Krystepan/PCB_Nissan_v2/bom/Faurecia_Nissan_RPi_Motor_Controller_v2.png

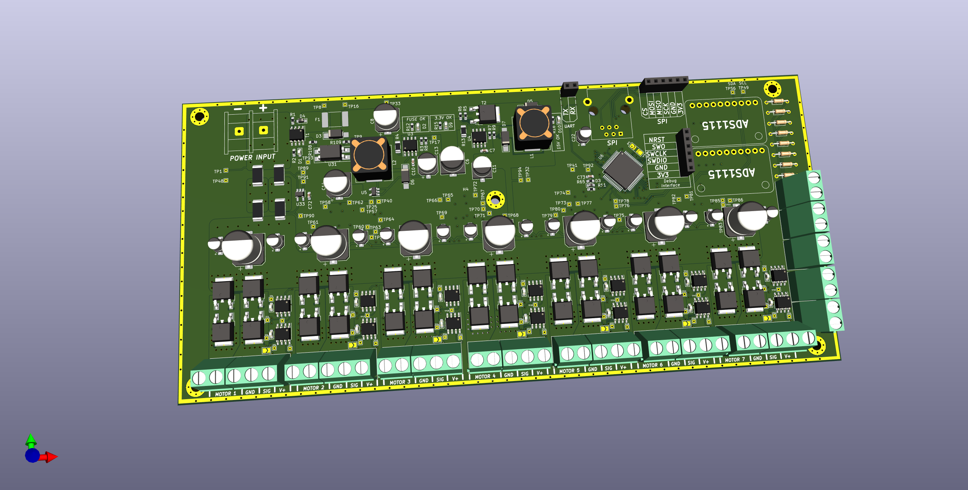
bom/Faurecia_Nissan_RPi_Motor_Controller_v2.png
