Krystepan/PCB_Nissan_v2/Faurecia_Nissan_RPi_Motor_Controller_v2_AR-Check.txt

AR checking written on:
'E:\Elektronika\10.KOMPLETNE PROJEKTY\FAURECIA_Nissan\PCB_Nissan_v2\Faurecia_Nissan_RPi_Motor_Controller_v2_AR-Check.txt'
'action_menu_annular_check.py'
version = 1.7.2
Testing PCB for Annular Rings
TH Pads >= 0.2 Vias >= 0.2
PHD margin on PTH = 0.3

AR Via violation of 0.0 at XY 189.789055,166.760257
AR Via violation of 0.05 at XY 170.883249,160.802444
AR Via violation of 0.0 at XY 141.666668,164.6375
AR Via violation of 0.0 at XY 248.716668,175.5475
AR Via violation of 0.05 at XY 198.798249,160.802444
AR Via violation of 0.0 at XY 300.466668,175.5175
AR Via violation of 0.0 at XY 151.566668,187.1375
AR Via violation of 0.0 at XY 258.816668,87.6375
AR Via violation of 0.0 at XY 103.816668,96.1375
AR Via violation of 0.0 at XY 180.066668,187.1375
AR Via violation of 0.0 at XY 134.966668,156.0175
AR Via violation of 0.0 at XY 133.826668,175.5275
AR Via violation of 0.0 at XY 301.316668,87.6375
AR Via violation of 0.0 at XY 149.566668,108.8875
AR Via violation of 0.0 at XY 158.566668,108.8875
AR Via violation of 0.0 at XY 273.986668,156.0675
AR Via violation of 0.0 at XY 170.566668,187.1375
AR Via violation of 0.0 at XY 265.816668,187.1375
AR Via violation of 0.0 at XY 137.316668,187.1375
AR Via violation of 0.0 at XY 153.066668,100.8875
AR Via violation of 0.0 at XY 103.816668,124.6375
AR Via violation of 0.0 at XY 103.816668,143.6375
AR Via violation of 0.0 at XY 189.486668,175.5475
AR Via violation of 0.05 at XY 254.333249,160.857444
AR Via violation of 0.0 at XY 157.816668,87.6375
AR Via violation of 0.0 at XY 129.316668,87.6375
AR Via violation of 0.0 at XY 175.316668,187.1375
AR Via violation of 0.0 at XY 181.566668,87.6375
AR Via violation of 0.0 at XY 220.816668,87.6375
AR Via violation of 0.0 at XY 186.566668,110.6375
AR Via violation of 0.0 at XY 179.276668,164.0975
AR Via violation of 0.0 at XY 276.386668,175.5975
AR Via violation of 0.0 at XY 227.316668,94.3875
AR Via violation of 0.0 at XY 194.566668,187.1375
AR Via violation of 0.05 at XY 115.283249,160.794944
AR Via violation of 0.0 at XY 301.546668,165.4075
AR Via violation of 0.0 at XY 232.566668,187.1375
AR Via violation of 0.0 at XY 115.066668,87.6375
AR Via violation of 0.0 at XY 103.816668,172.1375
AR Via violation of 0.0 at XY 207.006668,164.0975
AR Via violation of 0.0 at XY 261.066668,187.1375
AR Via violation of 0.0 at XY 217.316668,175.5275
AR Via violation of 0.0 at XY 125.066668,133.6375
AR Via violation of 0.0 at XY 190.536668,155.9975
AR Via violation of 0.05 at XY 125.057267,160.7601
AR Via violation of 0.0 at XY 217.712687,166.736184
AR Via violation of 0.0 at XY 245.136668,175.5675
AR Via violation of 0.0 at XY 103.816668,153.1375
AR Via violation of 0.0 at XY 137.406668,175.5275
AR Via violation of 0.0 at XY 142.948395,119.897524
AR Via violation of 0.0 at XY 251.566668,187.1375
AR Via violation of 0.0 at XY 304.316668,187.1375
AR Via violation of 0.0 at XY 320.255573,163.640706
AR Via violation of 0.0 at XY 134.066668,87.6375
AR Via violation of 0.0 at XY 206.566668,87.6375
AR Via violation of 0.0 at XY 165.246668,175.5975
AR Via violation of 0.0 at XY 254.066668,87.6375
AR Via violation of 0.0 at XY 217.926668,154.0875
AR Via violation of 0.0 at XY 263.566668,87.6375
AR Via violation of 0.0 at XY 103.816668,167.3875
AR Via violation of 0.0 at XY 300.856668,166.7775
AR Via violation of 0.0 at XY 320.255573,168.390706
AR Via violation of 0.0 at XY 197.346668,164.6375
AR Via violation of 0.0 at XY 161.686668,175.6075
AR Via violation of 0.0 at XY 309.066668,187.1375
AR Via violation of 0.0 at XY 242.066668,187.1375
AR Via violation of 0.0 at XY 320.255573,97.140706
AR Via violation of 0.0 at XY 145.989759,120.889683
AR Via violation of 0.0 at XY 320.255573,144.640706
AR Via violation of 0.0 at XY 216.066668,87.6375
AR Via violation of 0.0 at XY 103.816668,134.1375
AR Via violation of 0.0 at XY 113.566668,187.1375
AR Via violation of 0.0 at XY 320.255573,149.390706
AR Via violation of 0.0 at XY 320.255573,154.140706
AR Via violation of 0.0 at XY 103.816668,129.3875
AR Via violation of 0.0 at XY 146.816668,187.1375
AR Via violation of 0.0 at XY 313.816668,187.1375
AR Via violation of 0.0 at XY 161.066668,187.1375
AR Via violation of 0.0 at XY 239.816668,87.6375
AR Via violation of 0.05 at XY 264.107267,160.8226
AR Via violation of 0.0 at XY 235.066668,87.6375
AR Via violation of 0.0 at XY 191.066668,87.6375
AR Via violation of 0.0 at XY 151.556668,164.1775
AR Via violation of 0.0 at XY 277.816668,87.6375
AR Via violation of 0.0 at XY 184.816668,187.1375
AR Via violation of 0.0 at XY 118.316668,187.1375
AR Via violation of 0.0 at XY 190.506668,165.3875
AR Via violation of 0.0 at XY 291.816668,87.6375
AR Via violation of 0.0 at XY 304.016668,175.4975
AR Via violation of 0.0 at XY 218.436668,155.3275
AR Via violation of 0.05 at XY 143.086668,160.8775
AR Via violation of 0.0 at XY 140.799999,93.846719
AR Via violation of 0.0 at XY 103.816668,138.8875
AR Via violation of 0.0 at XY 119.816668,87.6375
AR Via violation of 0.0 at XY 138.816668,87.6375
AR Via violation of 0.0 at XY 135.066668,135.3875
AR Via violation of 0.0 at XY 103.816668,157.8875
AR Via violation of 0.0 at XY 162.786668,156.0575
AR Via violation of 0.0 at XY 143.066668,105.6375
AR Via violation of 0.0 at XY 125.066668,136.1375
AR Via violation of 0.0 at XY 233.080979,100.046421
AR Via violation of 0.0 at XY 165.816668,187.1375
AR Via violation of 0.0 at XY 103.816668,100.8875
AR Via violation of 0.0 at XY 227.816668,187.1375
AR Via violation of 0.0 at XY 143.566668,87.6375
AR Via violation of 0.0 at XY 123.606668,164.1375
AR Via violation of 0.0 at XY 211.316668,87.6375
AR Via violation of 0.0 at XY 208.558823,104.523369
AR Via violation of 0.0 at XY 218.316668,187.1375
AR Via violation of 0.0 at XY 156.316668,187.1375
AR Via violation of 0.05 at XY 152.907267,160.8226
AR Via violation of 0.0 at XY 225.566668,87.6375
AR Via violation of 0.0 at XY 234.906668,164.1575
AR Via violation of 0.0 at XY 103.816668,115.1375
AR Via violation of 0.0 at XY 320.255573,177.890706
AR Via violation of 0.0 at XY 126.316668,133.6375
AR Via violation of 0.0 at XY 294.816668,187.1375
AR Via violation of 0.0 at XY 176.816668,87.6375
AR Via violation of 0.0 at XY 153.066668,87.6375
AR Via violation of 0.0 at XY 237.316668,187.1375
AR Via violation of 0.0 at XY 134.136668,166.7775
AR Via violation of 0.0 at XY 218.406668,165.2875
AR Via violation of 0.0 at XY 142.066668,187.1375
AR Via violation of 0.0 at XY 273.956668,165.5275
AR Via violation of 0.0 at XY 320.255573,106.640706
AR Via violation of 0.0 at XY 183.816668,99.8875
AR Via violation of 0.0 at XY 113.856668,164.6075
AR Via violation of 0.0 at XY 223.066668,187.1375
AR Via violation of 0.05 at XY 281.946668,160.78
AR Via violation of 0.0 at XY 262.646668,164.1975
AR Via violation of 0.0 at XY 273.246668,166.8275
AR Via violation of 0.05 at XY 247.466668,115.314
AR Via violation of 0.0 at XY 132.566668,187.1375
AR Via violation of 0.05 at XY 180.657267,160.7676
AR Via violation of 0.0 at XY 220.916668,175.5375
AR Via violation of 0.0 at XY 103.816668,148.3875
AR Via violation of 0.0 at XY 124.566668,87.6375
AR Via violation of 0.0 at XY 320.255573,125.640706
AR Via violation of 0.0 at XY 103.816668,162.6375
AR Via violation of 0.0 at XY 320.255573,116.140706
AR Via violation of 0.05 at XY 226.583249,160.802444
AR Via violation of 0.0 at XY 296.566668,87.6375
AR Via violation of 0.0 at XY 280.566668,187.1375
AR Via violation of 0.0 at XY 320.255573,135.140706
AR Via violation of 0.0 at XY 246.816668,187.1375
AR Via violation of 0.0 at XY 103.816668,105.6375
AR Via violation of 0.0 at XY 201.816668,87.6375
AR Via violation of 0.0 at XY 246.226668,156.0275
AR Via violation of 0.0 at XY 244.566668,87.6375
AR Via violation of 0.0 at XY 252.766668,164.2675
AR Via violation of 0.0 at XY 116.316668,135.3875
AR Via violation of 0.0 at XY 103.816668,119.8875
AR Via violation of 0.0 at XY 320.255573,158.890706
AR Via violation of 0.0 at XY 192.996668,175.5175
AR Via violation of 0.0 at XY 268.316668,87.6375
AR Via violation of 0.0 at XY 103.816668,110.3875
AR Via violation of 0.0 at XY 205.066668,118.6375
AR Via violation of 0.0 at XY 162.016668,166.8175
AR Via violation of 0.0 at XY 126.316668,136.1375
AR Via violation of 0.0 at XY 320.255573,130.390706
AR Via violation of 0.0 at XY 285.316668,187.1375
AR Via violation of 0.0 at XY 208.816668,187.1375
AR Via violation of 0.0 at XY 167.316668,87.6375
AR Via violation of 0.0 at XY 270.566668,187.1375
AR Via violation of 0.0 at XY 230.316668,87.6375
AR Via violation of 0.0 at XY 282.566668,87.6375
AR Via violation of 0.0 at XY 261.066668,121.9125
AR Via violation of 0.0 at XY 156.066668,115.6375
AR Via violation of 0.0 at XY 320.255573,101.890706
AR Via violation of 0.0 at XY 193.566668,100.1375
AR Via violation of 0.0 at XY 103.816668,176.8875
AR Via violation of 0.0 at XY 189.566668,187.1375
AR Via violation of 0.0 at XY 108.816668,187.1375
AR Via violation of 0.0 at XY 272.826668,175.6175
AR Via violation of 0.0 at XY 134.906668,165.4375
AR Via violation of 0.0 at XY 127.816668,187.1375
AR Via violation of 0.0 at XY 306.066668,87.6375
AR Via violation of 0.0 at XY 160.683314,127.710046
AR Via violation of 0.0 at XY 320.255573,173.140706
AR Via violation of 0.0 at XY 148.316668,87.6375
AR Via violation of 0.0 at XY 195.816668,87.6375
AR Via violation of 0.05 at XY 291.720686,160.745156
AR Via violation of 0.0 at XY 245.524086,166.738215
AR Via violation of 0.0 at XY 301.576668,155.9475
AR Via violation of 0.0 at XY 225.016668,164.2475
AR Via violation of 0.0 at XY 287.066668,87.6375
AR Via violation of 0.0 at XY 320.255573,139.890706
AR Via violation of 0.0 at XY 169.276668,164.5175
AR Via violation of 0.0 at XY 273.066668,87.6375
AR Via violation of 0.0 at XY 199.316668,187.1375
AR Via violation of 0.0 at XY 320.255573,111.390706
AR Via violation of 0.0 at XY 246.186668,165.3775
AR Via violation of 0.0 at XY 275.316668,187.1375
AR Via violation of 0.05 at XY 208.572267,160.7676
AR Via violation of 0.0 at XY 162.566668,87.6375
AR Via violation of 0.0 at XY 172.066668,87.6375
AR Via violation of 0.0 at XY 123.066668,187.1375
AR Via violation of 0.0 at XY 204.066668,187.1375
AR Via violation of 0.0 at XY 249.316668,87.6375
AR Via violation of 0.0 at XY 290.176668,164.0575
AR Via violation of 0.0 at XY 256.316668,187.1375
AR Via violation of 0.0 at XY 213.566668,187.1375
AR Via violation of 0.0 at XY 299.566668,187.1375
AR Via violation of 0.05 at XY 236.357267,160.7676
AR Via violation of 0.0 at XY 186.316668,87.6375
AR Via violation of 0.0 at XY 320.255573,120.890706
AR Via violation of 0.0 at XY 153.638862,123.097665
AR Via violation of 0.0 at XY 290.066668,187.1375
AR Via violation of 0.0 at XY 162.736668,165.5675
AR Via violation of 0.0 at XY 299.866668,139.6875
AR Via violation of 0.05 at XY 249.833249,140.102444
AR Via violation of 0.05 at XY 277.183249,167.157444
AR Via violation of 0.05 at XY 305.395059,155.862804
AR Via violation of 0.05 at XY 166.58164,155.940248
AR Via violation of 0.05 at XY 194.33164,155.885248
AR Via violation of 0.05 at XY 222.048249,140.102444
AR Via violation of 0.05 at XY 191.133249,159.502444
AR Via violation of 0.05 at XY 250.03164,155.885248
AR Via violation of 0.0 at XY 144.296724,138.9625
AR Via violation of 0.05 at XY 135.533249,159.494944
AR Via violation of 0.05 at XY 138.133249,167.094944
AR Via violation of 0.05 at XY 249.433249,167.102444
AR Via violation of 0.05 at XY 222.24664,155.885248
AR Via violation of 0.05 at XY 193.733249,167.102444
AR Via violation of 0.0 at XY 135.133249,138.944944
AR Via violation of 0.05 at XY 165.983249,167.157444
AR Via violation of 0.05 at XY 163.383249,159.557444
AR Via violation of 0.05 at XY 302.196668,159.48
AR Via violation of 0.05 at XY 138.73164,155.877748
AR Via violation of 0.05 at XY 221.648249,167.102444
AR Via violation of 0.05 at XY 274.583249,159.557444
AR Via violation of 0.05 at XY 194.133249,140.102444
AR Via violation of 0.05 at XY 219.048249,159.502444
AR Via violation of 0.05 at XY 277.583249,140.157444
AR Via violation of 0.05 at XY 304.796668,167.08
AR Via violation of 0.05 at XY 166.383249,140.157444
AR Via violation of 0.05 at XY 246.833249,159.502444
AR Via violation of 0.0 at XY 116.35531,138.97555
AR Via violation of 0.05 at XY 277.78164,155.940248
AR Via violation of 0.0 at XY 198.559215,124.723719
AR Via violation of 0.0 at XY 195.479612,135.137785
AR Via violation of 0.0 at XY 136.176668,165.4175
AR Via violation of 0.0 at XY 145.989759,122.603745
AR Via violation of 0.0 at XY 258.066668,110.1875
AR Via violation of 0.0 at XY 265.291668,131.0125
AR Via violation of 0.0 at XY 157.146668,174.6675
AR Via violation of 0.0 at XY 151.308841,134.967301
AR Via violation of 0.0 at XY 191.776668,165.3575
AR Via violation of 0.0 at XY 262.166668,121.9875
AR Via violation of 0.0 at XY 240.596668,174.5875
AR Via violation of 0.0 at XY 302.816668,165.3575
AR Via violation of 0.0 at XY 254.566668,110.9625
AR Via violation of 0.0 at XY 275.256668,156.0675
AR Via violation of 0.0 at XY 234.816668,131.6375
AR Via violation of 0.0 at XY 136.186668,156.0275
AR Via violation of 0.0 at XY 278.291562,135.277625
AR Via violation of 0.0 at XY 277.68239,132.092477
AR Via violation of 0.0 at XY 247.496668,156.0175
AR Via violation of 0.0 at XY 254.766668,114.1125
AR Via violation of 0.0 at XY 249.341668,119.7625
AR Via violation of 0.05 at XY 280.666668,125.1875
AR Via violation of 0.0 at XY 240.991668,108.3125
AR Via violation of 0.0 at XY 129.296668,174.5875
AR Via violation of 0.0 at XY 260.466668,128.9125
AR Via violation of 0.05 at XY 265.541668,124.0375
AR Via violation of 0.0 at XY 219.716668,155.3675
AR Via violation of 0.0 at XY 219.696668,165.2975
AR Via violation of 0.0 at XY 302.856668,155.9575
AR Via violation of 0.0 at XY 143.938392,122.603745
AR Via violation of 0.0 at XY 164.036668,165.5675
AR Via violation of 0.0 at XY 159.989094,103.400824
AR Via violation of 0.0 at XY 239.641668,125.5375
AR Via violation of 0.0 at XY 249.741668,117.6875
AR Via violation of 0.0 at XY 245.741668,119.7875
AR Via violation of 0.0 at XY 156.324494,125.078891
AR Via violation of 0.0 at XY 164.056668,156.0475
AR Via violation of 0.0 at XY 295.936668,174.5975
AR Via violation of 0.0 at XY 241.091668,106.9875
AR Via violation of 0.05 at XY 265.333125,125.391918
AR Via violation of 0.0 at XY 191.566668,100.1375
AR Via violation of 0.0 at XY 212.796668,174.5875
AR Via violation of 0.05 at XY 234.576551,91.849677
AR Via violation of 0.0 at XY 253.591668,123.9625
AR Via violation of 0.0 at XY 156.041668,120.7375
AR Via violation of 0.0 at XY 195.185798,132.319349
AR Via violation of 0.0 at XY 268.306668,174.6575
AR Via violation of 0.0 at XY 275.196668,165.5375
AR Via violation of 0.0 at XY 191.816668,156.0475
AR Via violation of 0.05 at XY 239.751217,91.816435
AR Via violation of 0.0 at XY 247.466668,165.3675
AR Via violation of 0.0 at XY 184.856668,174.5875
AR Via violation of 0.0 at XY 250.066668,110.5625
AR Via violation of 0.0 at XY 248.316668,112.1625
AR Via violation of 0.0 at XY 259.116668,125.1375
AR Via violation of 0.0 at XY 260.291668,126.0875
AR Via violation of 0.05 at XY 169.791668,129.1875
AR Via violation of 0.0 at XY 261.441668,125.8625
AR Via violation of 0.0 at XY 262.066668,124.7875
AR Via violation of 0.0 at XY 201.666668,136.2375
AR Via violation of 0.0 at XY 251.066668,116.3875
AR Via violation of 0.0 at XY 259.291668,113.8625
AR Via violation of 0.0 at XY 153.066668,127.6875
AR Via violation of 0.0 at XY 246.366668,123.9875
AR Via violation of 0.0 at XY 156.916668,127.6875
AR Via violation of 0.0 at XY 244.941668,124.6125
AR Via violation of 0.0 at XY 159.416668,132.6375
AR Via violation of 0.05 at XY 167.716668,129.4125
AR Via violation of 0.0 at XY 155.616668,132.6375
AR Via violation of 0.0 at XY 195.166668,127.3875
AR Via violation of 0.05 at XY 245.541668,128.3125
AR Via violation of 0.0 at XY 198.966668,127.3375
AR Via violation of 0.0 at XY 197.716668,132.3875
AR Via violation of 0.0 at XY 201.516668,132.3375
AR Via violation of 0.0 at XY 248.666668,128.861
AR Via violation of 0.0 at XY 245.566668,115.2625
AR Via violation of 0.0 at XY 262.195477,123.896403
AR Via violation of 0.0 at XY 262.142136,123.071624
AR Via violation of 0.0 at XY 242.866668,136.2375
AR Via violation of 0.0 at XY 261.266668,115.5125
AR Via violation of 0.05 at XY 132.966668,157.6875
AR Via violation of 0.0 at XY 258.816668,112.7625
AR Via violation of 0.0 at XY 240.266668,127.1375
AR Via violation of 0.0 at XY 236.456668,127.1625
AR Via violation of 0.0 at XY 242.806668,132.1125
AR Via violation of 0.0 at XY 238.966668,132.0875
AR Via violation of 0.05 at XY 256.066668,122.0625
AR Via violation of 0.05 at XY 131.883249,167.344944
AR Via violation of 0.05 at XY 277.631668,127.1375
AR Via violation of 0.05 at XY 281.466668,127.1875
AR Via violation of 0.0 at XY 254.341668,115.5375
AR Via violation of 0.0 at XY 280.216668,132.1875
AR Via violation of 0.0 at XY 284.004168,132.115
AR Via violation of 0.05 at XY 160.816668,157.75
AR Via violation of 0.05 at XY 159.733249,167.407444
AR Via violation of 0.05 at XY 188.566668,157.695
AR Via violation of 0.05 at XY 187.483249,167.352444
AR Via violation of 0.05 at XY 216.481668,157.695
AR Via violation of 0.05 at XY 215.398249,167.352444
AR Via violation of 0.05 at XY 244.266668,157.695
AR Via violation of 0.05 at XY 243.183249,167.352444
AR Via violation of 0.05 at XY 272.016668,157.75
AR Via violation of 0.05 at XY 270.933249,167.407444
AR Via violation of 0.0 at XY 139.666668,153.1375
AR Via violation of 0.05 at XY 134.873249,157.634944
AR Via violation of 0.0 at XY 149.316668,138.8375
AR Via violation of 0.0 at XY 150.716668,138.8375
AR Via violation of 0.05 at XY 134.033249,168.169944
AR Via violation of 0.0 at XY 167.816668,138.9375
AR Via violation of 0.0 at XY 167.466668,153.6375
AR Via violation of 0.05 at XY 162.723249,157.697444
AR Via violation of 0.0 at XY 169.716668,138.9875
AR Via violation of 0.05 at XY 161.883249,168.232444
AR Via violation of 0.0 at XY 204.266668,133.2375
AR Via violation of 0.05 at XY 218.388249,157.642444
AR Via violation of 0.0 at XY 220.466668,140.0875
AR Via violation of 0.05 at XY 217.548249,168.177444
AR Via violation of 0.0 at XY 223.766668,140.0875
AR Via violation of 0.0 at XY 198.985359,131.611141
AR Via violation of 0.05 at XY 190.473249,157.642444
AR Via violation of 0.0 at XY 192.566668,140.1375
AR Via violation of 0.0 at XY 195.766668,140.1375
AR Via violation of 0.05 at XY 189.633249,168.177444
AR Via violation of 0.0 at XY 247.066668,133.3375
AR Via violation of 0.05 at XY 273.923249,157.697444
AR Via violation of 0.0 at XY 240.266668,133.8875
AR Via violation of 0.05 at XY 273.083249,168.232444
AR Via violation of 0.0 at XY 248.316668,140.1875
AR Via violation of 0.05 at XY 246.173249,157.642444
AR Via violation of 0.05 at XY 245.333249,168.177444
AR Via violation of 0.0 at XY 251.716668,140.0875
AR Via violation of 0.05 at XY 299.630087,157.672556
AR Via violation of 0.05 at XY 298.546668,167.33
AR Via violation of 0.0 at XY 253.141668,126.3875
AR Via violation of 0.0 at XY 251.516668,120.1375
AR Via violation of 0.0 at XY 253.441668,99.8125
AR Via violation of 0.05 at XY 252.040168,121.414
AR Via violation of 0.0 at XY 254.541668,98.9875
AR Via violation of 0.0 at XY 254.141668,126.6875
AR Via violation of 0.05 at XY 301.536668,157.62
AR Via violation of 0.05 at XY 300.696668,168.155
AR Via violation of 0.0 at XY 239.739168,93.9875
AR Via violation of 0.0 at XY 234.714168,93.9875
AR Via violation of 0.0 at XY 121.466668,166.4375
AR Via violation of 0.0 at XY 116.733334,171.4375
AR Via violation of 0.0 at XY 120.066668,171.4375
AR Via violation of 0.0 at XY 121.466668,168.0375
AR Via violation of 0.0 at XY 115.066668,171.4375
AR Via violation of 0.05 at XY 119.965749,164.744944
AR Via violation of 0.05 at XY 119.870749,157.369944
AR Via violation of 0.0 at XY 113.666668,169.8375
AR Via violation of 0.05 at XY 132.906668,163.8575
AR Via violation of 0.0 at XY 113.666668,168.2375
AR Via violation of 0.0 at XY 118.4,171.4375
AR Via violation of 0.0 at XY 113.666668,166.6375
AR Via violation of 0.0 at XY 121.466668,169.6375
AR Via violation of 0.0 at XY 123.466668,166.4375
AR Via violation of 0.0 at XY 123.466668,168.0375
AR Via violation of 0.0 at XY 125.866668,171.4375
AR Via violation of 0.05 at XY 136.633249,168.494944
AR Via violation of 0.0 at XY 124.266668,171.4375
AR Via violation of 0.0 at XY 127.466668,171.4375
AR Via violation of 0.0 at XY 123.466668,169.6375
AR Via violation of 0.0 at XY 129.066668,171.4375
AR Via violation of 0.0 at XY 146.25,171.5
AR Via violation of 0.0 at XY 149.316668,168.1
AR Via violation of 0.05 at XY 147.720749,157.432444
AR Via violation of 0.0 at XY 141.516668,169.9
AR Via violation of 0.0 at XY 149.316668,166.5
AR Via violation of 0.05 at XY 147.815749,164.807444
AR Via violation of 0.0 at XY 142.916668,171.5
AR Via violation of 0.0 at XY 149.316668,169.7
AR Via violation of 0.0 at XY 141.516668,168.3
AR Via violation of 0.05 at XY 160.706668,163.9775
AR Via violation of 0.0 at XY 144.583334,171.5
AR Via violation of 0.0 at XY 147.916668,171.5
AR Via violation of 0.0 at XY 141.516668,166.7
AR Via violation of 0.0 at XY 153.716668,171.5
AR Via violation of 0.0 at XY 151.316668,166.5
AR Via violation of 0.0 at XY 155.316668,171.5
AR Via violation of 0.0 at XY 156.916668,171.5
AR Via violation of 0.0 at XY 151.316668,169.7
AR Via violation of 0.0 at XY 152.116668,171.5
AR Via violation of 0.05 at XY 164.483249,168.557444
AR Via violation of 0.0 at XY 151.316668,168.1
AR Via violation of 0.05 at XY 175.565749,164.752444
AR Via violation of 0.0 at XY 169.266668,168.245
AR Via violation of 0.0 at XY 172.333334,171.445
AR Via violation of 0.0 at XY 177.066668,166.445
AR Via violation of 0.0 at XY 177.066668,169.645
AR Via violation of 0.0 at XY 169.266668,166.645
AR Via violation of 0.05 at XY 188.276668,163.9375
AR Via violation of 0.0 at XY 174.0,171.445
AR Via violation of 0.0 at XY 175.666668,171.445
AR Via violation of 0.0 at XY 169.266668,169.845
AR Via violation of 0.0 at XY 170.666668,171.445
AR Via violation of 0.05 at XY 175.470749,157.377444
AR Via violation of 0.0 at XY 177.066668,168.045
AR Via violation of 0.05 at XY 192.233249,168.502444
AR Via violation of 0.0 at XY 184.666668,171.445
AR Via violation of 0.0 at XY 179.066668,168.045
AR Via violation of 0.0 at XY 179.066668,166.445
AR Via violation of 0.0 at XY 183.066668,171.445
AR Via violation of 0.0 at XY 181.466668,171.445
AR Via violation of 0.0 at XY 179.066668,169.645
AR Via violation of 0.0 at XY 179.866668,171.445
AR Via violation of 0.0 at XY 198.581668,171.445
AR Via violation of 0.0 at XY 204.981668,166.445
AR Via violation of 0.0 at XY 204.981668,169.645
AR Via violation of 0.0 at XY 197.181668,166.645
AR Via violation of 0.0 at XY 201.915,171.445
AR Via violation of 0.0 at XY 200.248334,171.445
AR Via violation of 0.05 at XY 216.346668,163.8675
AR Via violation of 0.05 at XY 203.480749,164.752444
AR Via violation of 0.05 at XY 203.385749,157.377444
AR Via violation of 0.0 at XY 197.181668,169.845
AR Via violation of 0.0 at XY 204.981668,168.045
AR Via violation of 0.0 at XY 197.181668,168.245
AR Via violation of 0.0 at XY 203.581668,171.445
AR Via violation of 0.0 at XY 210.981668,171.445
AR Via violation of 0.0 at XY 209.381668,171.445
AR Via violation of 0.05 at XY 220.148249,168.502444
AR Via violation of 0.0 at XY 212.581668,171.445
AR Via violation of 0.0 at XY 206.981668,169.645
AR Via violation of 0.0 at XY 206.981668,168.045
AR Via violation of 0.0 at XY 207.781668,171.445
AR Via violation of 0.0 at XY 206.981668,166.445
AR Via violation of 0.0 at XY 231.366668,171.445
AR Via violation of 0.0 at XY 232.766668,168.045
AR Via violation of 0.0 at XY 224.966668,166.645
AR Via violation of 0.0 at XY 228.033334,171.445
AR Via violation of 0.05 at XY 244.166668,163.8675
AR Via violation of 0.05 at XY 231.265749,164.752444
AR Via violation of 0.0 at XY 232.766668,169.645
AR Via violation of 0.05 at XY 231.170749,157.377444
AR Via violation of 0.0 at XY 224.966668,168.245
AR Via violation of 0.0 at XY 232.766668,166.445
AR Via violation of 0.0 at XY 229.7,171.445
AR Via violation of 0.0 at XY 224.966668,169.845
AR Via violation of 0.0 at XY 226.366668,171.445
AR Via violation of 0.0 at XY 237.166668,171.445
AR Via violation of 0.0 at XY 234.766668,169.645
AR Via violation of 0.0 at XY 235.566668,171.445
AR Via violation of 0.0 at XY 234.766668,166.445
AR Via violation of 0.0 at XY 234.766668,168.045
AR Via violation of 0.05 at XY 247.933249,168.502444
AR Via violation of 0.0 at XY 238.766668,171.445
AR Via violation of 0.0 at XY 240.366668,171.445
AR Via violation of 0.05 at XY 259.015749,164.807444
AR Via violation of 0.0 at XY 260.516668,168.1
AR Via violation of 0.0 at XY 257.45,171.5
AR Via violation of 0.0 at XY 254.116668,171.5
AR Via violation of 0.05 at XY 271.966668,163.9875
AR Via violation of 0.0 at XY 260.516668,166.5
AR Via violation of 0.05 at XY 258.920749,157.432444
AR Via violation of 0.0 at XY 255.783334,171.5
AR Via violation of 0.0 at XY 252.716668,166.7
AR Via violation of 0.0 at XY 260.516668,169.7
AR Via violation of 0.0 at XY 259.116668,171.5
AR Via violation of 0.0 at XY 252.716668,169.9
AR Via violation of 0.0 at XY 252.716668,168.3
AR Via violation of 0.0 at XY 262.516668,169.7
AR Via violation of 0.0 at XY 262.516668,166.5
AR Via violation of 0.0 at XY 268.116668,171.5
AR Via violation of 0.0 at XY 266.516668,171.5
AR Via violation of 0.0 at XY 262.516668,168.1
AR Via violation of 0.05 at XY 275.683249,168.557444
AR Via violation of 0.0 at XY 263.316668,171.5
AR Via violation of 0.0 at XY 264.916668,171.5
AR Via violation of 0.0 at XY 288.130087,166.422556
AR Via violation of 0.0 at XY 281.730087,171.422556
AR Via violation of 0.05 at XY 286.534168,157.355
AR Via violation of 0.0 at XY 286.730087,171.422556
AR Via violation of 0.0 at XY 288.130087,169.622556
AR Via violation of 0.0 at XY 280.330087,168.222556
AR Via violation of 0.0 at XY 283.396753,171.422556
AR Via violation of 0.0 at XY 288.130087,168.022556
AR Via violation of 0.0 at XY 285.063419,171.422556
AR Via violation of 0.05 at XY 286.629168,164.73
AR Via violation of 0.0 at XY 280.330087,169.822556
AR Via violation of 0.05 at XY 299.566668,163.8575
AR Via violation of 0.0 at XY 280.330087,166.622556
AR Via violation of 0.0 at XY 290.130087,166.422556
AR Via violation of 0.0 at XY 290.130087,169.622556
AR Via violation of 0.0 at XY 290.130087,168.022556
AR Via violation of 0.0 at XY 292.530087,171.422556
AR Via violation of 0.05 at XY 303.296668,168.48
AR Via violation of 0.0 at XY 295.730087,171.422556
AR Via violation of 0.0 at XY 290.930087,171.422556
AR Via violation of 0.0 at XY 294.130087,171.422556
AR Via violation of 0.05 at XY 288.920668,118.366
AR Via violation of 0.0 at XY 286.270668,118.366
AR Via violation of 0.0 at XY 283.570668,118.416
AR Via violation of 0.0 at XY 280.941668,118.3625
AR Via violation of 0.0 at XY 261.491668,129.3875
AR Via violation of 0.0 at XY 288.966668,102.975
AR Via violation of 0.0 at XY 286.316668,102.975
AR Via violation of 0.0 at XY 283.666668,102.975
AR Via violation of 0.0 at XY 280.916668,103.025
AR Via violation of 0.0 at XY 244.916668,111.2875
AR Via violation of 0.0 at XY 131.133249,176.494944
AR Via violation of 0.0 at XY 244.891668,112.2375
AR Via violation of 0.05 at XY 157.133249,176.469944
AR Via violation of 0.0 at XY 244.891668,113.2875
AR Via violation of 0.05 at XY 184.883249,176.414944
AR Via violation of 0.05 at XY 212.798249,176.414944
AR Via violation of 0.0 at XY 244.866668,114.4375
AR Via violation of 0.0 at XY 257.016668,128.7625
AR Via violation of 0.0 at XY 240.583249,176.414944
AR Via violation of 0.0 at XY 258.28835,128.765818
AR Via violation of 0.0 at XY 268.333249,176.469944
AR Via violation of 0.0 at XY 259.191668,128.8875
AR Via violation of 0.0 at XY 295.946668,176.3925
AR Via violation of 0.0 at XY 263.591668,128.5625
AR Via violation of 0.0 at XY 138.816668,102.8875
AR Via violation of 0.0 at XY 138.816668,108.8875
AR Via violation of 0.0 at XY 130.316668,102.8875
AR Via violation of 0.0 at XY 134.316668,102.8875
AR Via violation of 0.0 at XY 126.316668,108.8875
AR Via violation of 0.0 at XY 138.316668,93.6375
AR Via violation of 0.0 at XY 130.316668,108.8875
AR Via violation of 0.0 at XY 125.816668,93.6375
AR Via violation of 0.0 at XY 133.816668,93.6375
AR Via violation of 0.0 at XY 134.316668,108.8875
AR Via violation of 0.0 at XY 126.316668,102.8875
AR Via violation of 0.0 at XY 129.816668,93.6375
AR Via violation of 0.0 at XY 245.116668,121.8875
AR Via violation of 0.0 at XY 264.616668,147.2
AR Via violation of 0.0 at XY 294.230087,147.122556
AR Via violation of 0.0 at XY 121.566668,149.1375
AR Via violation of 0.0 at XY 155.416668,147.2
AR Via violation of 0.0 at XY 226.866668,147.145
AR Via violation of 0.0 at XY 234.866668,151.145
AR Via violation of 0.0 at XY 197.081668,149.145
AR Via violation of 0.05 at XY 113.566668,147.1375
AR Via violation of 0.0 at XY 131.566668,147.1375
AR Via violation of 0.0 at XY 145.416668,147.2
AR Via violation of 0.0 at XY 121.566668,151.1375
AR Via violation of 0.0 at XY 213.081668,147.145
AR Via violation of 0.0 at XY 252.616668,151.2
AR Via violation of 0.0 at XY 242.866668,149.145
AR Via violation of 0.0 at XY 280.230087,147.122556
AR Via violation of 0.0 at XY 280.230087,151.122556
AR Via violation of 0.0 at XY 268.616668,147.2
AR Via violation of 0.0 at XY 232.866668,149.145
AR Via violation of 0.0 at XY 282.230087,147.122556
AR Via violation of 0.0 at XY 117.566668,147.1375
AR Via violation of 0.0 at XY 187.166668,149.145
AR Via violation of 0.0 at XY 135.67381,130.8875
AR Via violation of 0.0 at XY 125.566668,147.1375
AR Via violation of 0.0 at XY 149.416668,149.2
AR Via violation of 0.0 at XY 125.495239,130.8875
AR Via violation of 0.0 at XY 149.416668,151.2
AR Via violation of 0.0 at XY 139.066668,130.8875
AR Via violation of 0.0 at XY 159.416668,149.2
AR Via violation of 0.0 at XY 284.230087,147.122556
AR Via violation of 0.0 at XY 207.081668,149.145
AR Via violation of 0.0 at XY 215.081668,149.145
AR Via violation of 0.0 at XY 123.566668,147.1375
AR Via violation of 0.0 at XY 207.081668,147.145
AR Via violation of 0.0 at XY 113.566668,151.1375
AR Via violation of 0.0 at XY 197.081668,147.145
AR Via violation of 0.0 at XY 240.866668,147.145
AR Via violation of 0.0 at XY 211.081668,147.145
AR Via violation of 0.0 at XY 228.866668,147.145
AR Via violation of 0.0 at XY 131.566668,149.1375
AR Via violation of 0.0 at XY 290.230087,149.122556
AR Via violation of 0.0 at XY 187.166668,147.145
AR Via violation of 0.0 at XY 179.166668,149.145
AR Via violation of 0.0 at XY 288.230087,147.122556
AR Via violation of 0.0 at XY 205.081668,147.145
AR Via violation of 0.0 at XY 232.866668,151.145
AR Via violation of 0.0 at XY 262.616668,149.2
AR Via violation of 0.0 at XY 205.081668,151.145
AR Via violation of 0.0 at XY 197.081668,151.145
AR Via violation of 0.0 at XY 151.416668,149.2
AR Via violation of 0.0 at XY 141.416668,147.2
AR Via violation of 0.0 at XY 127.566668,147.1375
AR Via violation of 0.0 at XY 113.566668,149.1375
AR Via violation of 0.0 at XY 298.230087,151.122556
AR Via violation of 0.0 at XY 187.166668,151.145
AR Via violation of 0.0 at XY 205.081668,149.145
AR Via violation of 0.0 at XY 151.416668,147.2
AR Via violation of 0.0 at XY 118.709525,130.8875
AR Via violation of 0.0 at XY 171.166668,147.145
AR Via violation of 0.0 at XY 209.081668,147.145
AR Via violation of 0.0 at XY 181.166668,147.145
AR Via violation of 0.0 at XY 147.416668,147.2
AR Via violation of 0.0 at XY 260.616668,149.2
AR Via violation of 0.0 at XY 159.416668,147.2
AR Via violation of 0.0 at XY 262.616668,147.2
AR Via violation of 0.0 at XY 159.416668,151.2
AR Via violation of 0.0 at XY 141.416668,151.2
AR Via violation of 0.0 at XY 260.616668,147.2
AR Via violation of 0.0 at XY 199.081668,147.145
AR Via violation of 0.0 at XY 288.230087,149.122556
AR Via violation of 0.0 at XY 131.566668,151.1375
AR Via violation of 0.0 at XY 215.081668,147.145
AR Via violation of 0.0 at XY 286.230087,147.122556
AR Via violation of 0.0 at XY 153.416668,147.2
AR Via violation of 0.0 at XY 185.166668,147.145
AR Via violation of 0.0 at XY 232.866668,147.145
AR Via violation of 0.0 at XY 298.230087,147.122556
AR Via violation of 0.0 at XY 270.616668,149.2
AR Via violation of 0.0 at XY 298.230087,149.122556
AR Via violation of 0.0 at XY 252.616668,149.2
AR Via violation of 0.0 at XY 224.866668,147.145
AR Via violation of 0.0 at XY 141.416668,149.2
AR Via violation of 0.0 at XY 151.416668,151.2
AR Via violation of 0.0 at XY 252.616668,147.2
AR Via violation of 0.0 at XY 173.166668,147.145
AR Via violation of 0.0 at XY 203.081668,147.145
AR Via violation of 0.0 at XY 143.416668,147.2
AR Via violation of 0.0 at XY 234.866668,149.145
AR Via violation of 0.0 at XY 177.166668,147.145
AR Via violation of 0.0 at XY 207.081668,151.145
AR Via violation of 0.0 at XY 179.166668,151.145
AR Via violation of 0.0 at XY 242.866668,147.145
AR Via violation of 0.0 at XY 115.316668,130.8875
AR Via violation of 0.0 at XY 123.566668,149.1375
AR Via violation of 0.0 at XY 157.416668,147.2
AR Via violation of 0.0 at XY 242.866668,151.145
AR Via violation of 0.0 at XY 201.081668,147.145
AR Via violation of 0.0 at XY 119.566668,147.1375
AR Via violation of 0.0 at XY 179.166668,147.145
AR Via violation of 0.0 at XY 230.866668,147.145
AR Via violation of 0.0 at XY 115.566668,147.1375
AR Via violation of 0.0 at XY 292.230087,147.122556
AR Via violation of 0.0 at XY 169.166668,147.145
AR Via violation of 0.0 at XY 234.866668,147.145
AR Via violation of 0.0 at XY 169.166668,151.145
AR Via violation of 0.0 at XY 121.566668,147.1375
AR Via violation of 0.0 at XY 266.616668,147.2
AR Via violation of 0.0 at XY 262.616668,151.2
AR Via violation of 0.0 at XY 260.616668,151.2
AR Via violation of 0.0 at XY 290.230087,151.122556
AR Via violation of 0.0 at XY 215.081668,151.145
AR Via violation of 0.0 at XY 254.616668,147.2
AR Via violation of 0.0 at XY 177.166668,151.145
AR Via violation of 0.0 at XY 258.616668,147.2
AR Via violation of 0.0 at XY 280.230087,149.122556
AR Via violation of 0.0 at XY 122.102382,130.8875
AR Via violation of 0.0 at XY 224.866668,151.145
AR Via violation of 0.0 at XY 296.230087,147.122556
AR Via violation of 0.0 at XY 129.566668,147.1375
AR Via violation of 0.0 at XY 177.166668,149.145
AR Via violation of 0.0 at XY 256.616668,147.2
AR Via violation of 0.0 at XY 270.616668,151.2
AR Via violation of 0.0 at XY 288.230087,151.122556
AR Via violation of 0.0 at XY 175.166668,147.145
AR Via violation of 0.0 at XY 224.866668,149.145
AR Via violation of 0.0 at XY 123.566668,151.1375
AR Via violation of 0.0 at XY 290.230087,147.122556
AR Via violation of 0.0 at XY 128.888096,130.8875
AR Via violation of 0.0 at XY 270.616668,147.2
AR Via violation of 0.0 at XY 238.866668,147.145
AR Via violation of 0.0 at XY 149.416668,147.2
AR Via violation of 0.0 at XY 183.166668,147.145
AR Via violation of 0.0 at XY 132.280953,130.8875
AR Via violation of 0.0 at XY 236.866668,147.145
AR Via violation of 0.0 at XY 169.166668,149.145
AR Via violation of 0.0 at XY 205.451668,101.8125
AR Via violation of 0.0 at XY 199.580147,100.186421
AR Via violation of 0.05 at XY 139.033249,173.894944
AR Via violation of 0.05 at XY 134.433249,159.494944
AR Via violation of 0.05 at XY 134.333249,161.044944
AR Via violation of 0.05 at XY 132.533249,170.994944
AR Via violation of 0.05 at XY 162.283249,159.557444
AR Via violation of 0.05 at XY 162.183249,161.107444
AR Via violation of 0.05 at XY 166.883249,173.957444
AR Via violation of 0.05 at XY 160.383249,171.057444
AR Via violation of 0.05 at XY 190.033249,159.502444
AR Via violation of 0.05 at XY 190.326668,161.052444
AR Via violation of 0.05 at XY 194.633249,173.902444
AR Via violation of 0.05 at XY 188.133249,171.002444
AR Via violation of 0.05 at XY 217.948249,159.502444
AR Via violation of 0.05 at XY 217.848249,161.052444
AR Via violation of 0.05 at XY 222.548249,173.902444
AR Via violation of 0.05 at XY 216.048249,171.002444
AR Via violation of 0.05 at XY 245.733249,159.502444
AR Via violation of 0.05 at XY 245.633249,161.052444
AR Via violation of 0.05 at XY 250.333249,173.902444
AR Via violation of 0.05 at XY 243.833249,171.002444
AR Via violation of 0.05 at XY 273.483249,159.557444
AR Via violation of 0.05 at XY 273.383249,161.107444
AR Via violation of 0.05 at XY 278.083249,173.957444
AR Via violation of 0.05 at XY 271.583249,171.057444
AR Via violation of 0.05 at XY 301.096668,159.48
AR Via violation of 0.05 at XY 300.996668,161.03
AR Via violation of 0.05 at XY 305.696668,173.88
AR Via violation of 0.05 at XY 299.196668,170.98
AR Via violation of 0.05 at XY 119.866668,160.8375
AR Via violation of 0.05 at XY 130.983249,171.174944
AR Via violation of 0.05 at XY 124.983249,157.114944
AR Via violation of 0.05 at XY 129.666668,160.8375
AR Via violation of 0.05 at XY 147.716668,160.9
AR Via violation of 0.05 at XY 158.833249,171.237444
AR Via violation of 0.05 at XY 152.833249,157.177444
AR Via violation of 0.05 at XY 157.516668,160.9
AR Via violation of 0.05 at XY 175.466668,160.845
AR Via violation of 0.05 at XY 180.583249,157.122444
AR Via violation of 0.05 at XY 186.583249,171.182444
AR Via violation of 0.05 at XY 115.320143,157.368931
AR Via violation of 0.05 at XY 132.866668,162.2625
AR Via violation of 0.05 at XY 185.266668,160.845
AR Via violation of 0.05 at XY 203.381668,160.845
AR Via violation of 0.05 at XY 214.498249,171.182444
AR Via violation of 0.05 at XY 208.498249,157.122444
AR Via violation of 0.05 at XY 143.170143,157.431431
AR Via violation of 0.0 at XY 160.736668,162.3275
AR Via violation of 0.05 at XY 213.181668,160.845
AR Via violation of 0.05 at XY 231.166668,160.845
AR Via violation of 0.05 at XY 242.283249,171.182444
AR Via violation of 0.05 at XY 236.283249,157.122444
AR Via violation of 0.05 at XY 188.446668,162.1475
AR Via violation of 0.05 at XY 170.920143,157.376431
AR Via violation of 0.05 at XY 240.966668,160.845
AR Via violation of 0.05 at XY 258.916668,160.9
AR Via violation of 0.05 at XY 264.033249,157.177444
AR Via violation of 0.05 at XY 270.033249,171.237444
AR Via violation of 0.0 at XY 216.356668,162.2975
AR Via violation of 0.05 at XY 198.835143,157.376431
AR Via violation of 0.05 at XY 268.716668,160.9
AR Via violation of 0.05 at XY 286.530087,160.822556
AR Via violation of 0.05 at XY 291.646668,157.1
AR Via violation of 0.05 at XY 297.646668,171.16
AR Via violation of 0.05 at XY 244.176668,162.3275
AR Via violation of 0.05 at XY 226.620143,157.376431
AR Via violation of 0.05 at XY 296.330087,160.822556
AR Via violation of 0.05 at XY 254.370143,157.431431
AR Via violation of 0.05 at XY 271.926668,162.3775
AR Via violation of 0.05 at XY 281.983562,157.353987
AR Via violation of 0.05 at XY 299.546668,162.3075
AR Via violation of 0.05 at XY 132.283249,175.494944
AR Via violation of 0.05 at XY 160.133249,175.557444
AR Via violation of 0.05 at XY 187.883249,175.502444
AR Via violation of 0.05 at XY 215.798249,175.502444
AR Via violation of 0.05 at XY 243.583249,175.502444
AR Via violation of 0.05 at XY 271.333249,175.557444
AR Via violation of 0.05 at XY 298.946668,175.48
AR Via violation of 0.05 at XY 133.033249,173.694944
AR Via violation of 0.05 at XY 160.883249,173.757444
AR Via violation of 0.05 at XY 188.633249,173.702444
AR Via violation of 0.05 at XY 216.548249,173.702444
AR Via violation of 0.05 at XY 244.333249,173.702444
AR Via violation of 0.05 at XY 272.083249,173.757444
AR Via violation of 0.05 at XY 299.696668,173.68
AR Via violation of 0.05 at XY 139.233249,158.194944
AR Via violation of 0.0 at XY 166.766668,160.7875
AR Via violation of 0.05 at XY 195.006668,158.1275
AR Via violation of 0.05 at XY 222.748249,158.202444
AR Via violation of 0.05 at XY 250.533249,158.202444
AR Via violation of 0.05 at XY 278.283249,158.257444
AR Via violation of 0.05 at XY 305.896668,158.18
AR Via violation of 0.0 at XY 241.404168,121.9
AR Via violation of 0.05 at XY 138.966668,122.8375
AR Via violation of 0.05 at XY 138.966668,119.9375
AR Via violation of 0.05 at XY 133.366668,122.8375
AR Via violation of 0.05 at XY 133.366668,116.9375
AR Via violation of 0.05 at XY 133.366668,119.9375
AR Via violation of 0.05 at XY 138.966668,116.9375
AR Via violation of 0.05 at XY 126.166668,119.9375
AR Via violation of 0.05 at XY 131.266668,119.9375
AR Via violation of 0.05 at XY 126.166668,116.8375
AR Via violation of 0.05 at XY 126.066668,122.8375
AR Via violation of 0.05 at XY 131.266668,122.8375
AR Via violation of 0.05 at XY 131.266668,116.8375
VIAS that Pass = 0; Fails = 806
AR PTH violation of 0.1 at XY 237.266668,129.6375
AR PTH violation of 0.1 at XY 160.716668,156.1
AR PTH violation of 0.1 at XY 173.266668,89.8375
AR PTH violation of 0.1 at XY 188.466668,156.045
AR PTH violation of 0.1 at XY 251.066668,136.0375
AR PTH violation of 0.1 at XY 166.779153,125.060472
AR PTH violation of 0.0 at XY 110.763724,89.940444
AR PTH violation of 0.0 at XY 107.369612,89.940444
AR PTH violation of 0.0 at XY 109.066668,89.2375
AR PTH violation of 0.0 at XY 111.466668,91.6375
AR PTH violation of 0.0 at XY 106.666668,91.6375
AR PTH violation of 0.0 at XY 110.763724,93.334556
AR PTH violation of 0.0 at XY 109.066668,94.0375
AR PTH violation of 0.0 at XY 107.369612,93.334556
AR PTH violation of 0.1 at XY 222.298249,172.502444
AR PTH violation of 0.1 at XY 290.366668,131.4875
AR PTH violation of 0.1 at XY 214.798249,168.652444
AR PTH violation of 0.1 at XY 190.466668,131.6375
AR PTH violation of 0.1 at XY 163.666668,127.6375
AR PTH violation of 0.1 at XY 186.883249,168.652444
AR PTH violation of 0.1 at XY 190.091668,125.6375
AR PTH violation of 0.1 at XY 138.783249,172.494944
AR PTH violation of 0.1 at XY 144.066668,113.4375
AR PTH violation of 0.1 at XY 299.166668,156.022556
AR PTH violation of 0.1 at XY 206.666668,131.2375
AR PTH violation of 0.1 at XY 202.266668,124.6375
AR PTH violation of 0.1 at XY 250.441668,129.4625
AR PTH violation of 0.1 at XY 272.466668,130.1125
AR PTH violation of 0.1 at XY 192.026668,163.3375
AR PTH violation of 0.1 at XY 118.066668,114.8375
AR PTH violation of 0.1 at XY 166.633249,172.557444
AR PTH violation of 0.1 at XY 275.356668,163.3975
AR PTH violation of 0.1 at XY 287.741668,132.9125
AR PTH violation of 0.1 at XY 165.266668,133.6375
AR PTH violation of 0.1 at XY 189.266668,103.4375
AR PTH violation of 0.1 at XY 234.191668,125.4875
AR PTH violation of 0.1 at XY 131.283249,168.644944
AR PTH violation of 0.1 at XY 132.866668,156.0375
AR PTH violation of 0.1 at XY 297.946668,168.63
AR PTH violation of 0.1 at XY 159.466668,124.8375
AR PTH violation of 0.1 at XY 118.066668,111.2775
AR PTH violation of 0.1 at XY 298.246668,162.78
AR PTH violation of 0.1 at XY 305.446668,172.48
AR PTH violation of 0.1 at XY 296.416668,92.1875
AR PTH violation of 0.1 at XY 211.866668,132.4375
AR PTH violation of 0.1 at XY 204.666668,129.6375
AR PTH violation of 0.1 at XY 187.183249,162.802444
AR PTH violation of 0.0 at XY 313.466668,91.6375
AR PTH violation of 0.0 at XY 312.763724,89.940444
AR PTH violation of 0.0 at XY 309.369612,93.334556
AR PTH violation of 0.0 at XY 311.066668,94.0375
AR PTH violation of 0.0 at XY 311.066668,89.2375
AR PTH violation of 0.0 at XY 312.763724,93.334556
AR PTH violation of 0.0 at XY 309.369612,89.940444
AR PTH violation of 0.0 at XY 308.666668,91.6375
AR PTH violation of 0.1 at XY 167.866668,135.4375
AR PTH violation of 0.1 at XY 234.266668,129.6375
AR PTH violation of 0.1 at XY 166.466668,137.2375
AR PTH violation of 0.1 at XY 232.116668,131.6125
AR PTH violation of 0.1 at XY 270.333249,168.707444
AR PTH violation of 0.1 at XY 220.781668,120.2625
AR PTH violation of 0.1 at XY 142.916668,128.5125
AR PTH violation of 0.1 at XY 250.083249,172.502444
AR PTH violation of 0.1 at XY 151.666668,89.8375
AR PTH violation of 0.1 at XY 245.033249,172.002444
AR PTH violation of 0.1 at XY 242.583249,168.652444
AR PTH violation of 0.1 at XY 272.783249,172.057444
AR PTH violation of 0.1 at XY 216.381668,156.045
AR PTH violation of 0.1 at XY 151.266668,125.8375
AR PTH violation of 0.1 at XY 169.666668,131.4375
AR PTH violation of 0.1 at XY 271.916668,156.1
AR PTH violation of 0.1 at XY 229.291668,133.1625
AR PTH violation of 0.1 at XY 147.066668,132.4375
AR PTH violation of 0.1 at XY 161.583249,172.057444
AR PTH violation of 0.1 at XY 275.366668,129.1875
AR PTH violation of 0.1 at XY 158.866668,89.8375
AR PTH violation of 0.1 at XY 270.633249,162.857444
AR PTH violation of 0.1 at XY 192.866668,125.6375
AR PTH violation of 0.1 at XY 163.066668,103.2375
AR PTH violation of 0.1 at XY 277.833249,172.557444
AR PTH violation of 0.1 at XY 250.441668,131.2625
AR PTH violation of 0.1 at XY 241.866668,117.8
AR PTH violation of 0.1 at XY 236.466668,117.4625
AR PTH violation of 0.1 at XY 286.116668,137.6875
AR PTH violation of 0.0 at XY 107.119612,180.940444
AR PTH violation of 0.0 at XY 111.216668,182.6375
AR PTH violation of 0.0 at XY 108.816668,180.2375
AR PTH violation of 0.0 at XY 107.119612,184.334556
AR PTH violation of 0.0 at XY 108.816668,185.0375
AR PTH violation of 0.0 at XY 110.513724,184.334556
AR PTH violation of 0.0 at XY 110.513724,180.940444
AR PTH violation of 0.0 at XY 106.416668,182.6375
AR PTH violation of 0.1 at XY 169.319153,125.060472
AR PTH violation of 0.1 at XY 215.098249,162.802444
AR PTH violation of 0.1 at XY 136.396668,163.3375
AR PTH violation of 0.1 at XY 159.133249,168.707444
AR PTH violation of 0.1 at XY 204.666668,127.6375
AR PTH violation of 0.1 at XY 300.216668,92.1375
AR PTH violation of 0.1 at XY 287.791668,131.2625
AR PTH violation of 0.1 at XY 300.396668,171.98
AR PTH violation of 0.1 at XY 164.206668,163.2675
AR PTH violation of 0.1 at XY 159.433249,162.857444
AR PTH violation of 0.0 at XY 207.369612,128.334556
AR PTH violation of 0.0 at XY 207.369612,124.940444
AR PTH violation of 0.0 at XY 206.666668,126.6375
AR PTH violation of 0.0 at XY 210.763724,124.940444
AR PTH violation of 0.0 at XY 210.763724,128.334556
AR PTH violation of 0.0 at XY 211.466668,126.6375
AR PTH violation of 0.0 at XY 209.066668,129.0375
AR PTH violation of 0.0 at XY 209.066668,124.2375
AR PTH violation of 0.1 at XY 303.066668,163.2125
AR PTH violation of 0.0 at XY 315.716668,182.6375
AR PTH violation of 0.0 at XY 311.619612,180.940444
AR PTH violation of 0.0 at XY 315.013724,184.334556
AR PTH violation of 0.0 at XY 313.316668,180.2375
AR PTH violation of 0.0 at XY 313.316668,185.0375
AR PTH violation of 0.0 at XY 311.619612,184.334556
AR PTH violation of 0.0 at XY 315.013724,180.940444
AR PTH violation of 0.0 at XY 310.916668,182.6375
AR PTH violation of 0.1 at XY 219.966668,163.2675
AR PTH violation of 0.1 at XY 194.383249,172.502444
AR PTH violation of 0.1 at XY 218.241668,120.2625
AR PTH violation of 0.1 at XY 145.716668,109.8875
AR PTH violation of 0.1 at XY 144.066668,116.6375
AR PTH violation of 0.1 at XY 217.248249,172.002444
AR PTH violation of 0.1 at XY 133.733249,171.994944
AR PTH violation of 0.1 at XY 189.333249,172.002444
AR PTH violation of 0.1 at XY 244.166668,156.045
AR PTH violation of 0.1 at XY 131.583249,162.794944
AR PTH violation of 0.1 at XY 242.883249,162.802444
AR PTH violation of 0.1 at XY 247.646668,163.3375
TH PADS that Pass = 110; Fails = 131
NPTH PADS that Pass = 0; Fails = 0
