Krystepan/PCB_Nissan_v2/(commit log)

2023-01-13 test change schematic
    [Faurecia_Nissan_RPi_Motor_Controller_v2.kicad_sch]
2023-01-15 added motor rotate hall sensor translator circuit in H-bridge modules, hierarchical schematic layout visual correction due to add HALL_OUT output
    [Faurecia_Nissan_RPi_Motor_Controller_v2.kicad_sch, H_bridge.kicad_sch]
2023-01-15 add EEPROM funcionality, created new hierarchical sheet
    [Faurecia_Nissan_RPi_Motor_Controller_v2.kicad_sch, H_bridge.kicad_sch, MCU.kicad_sch, eeprom.kicad_sch]
2023-01-15 added analog modules hierarhical sheet contains ADS1115 ADC
    [Faurecia_Nissan_RPi_Motor_Controller_v2.kicad_sch, analog_module.kicad_sch, eeprom.kicad_sch]
2023-01-16 added power loss detection, preparing for new pcb layout
    [Debugger_port.kicad_sch, Faurecia_Nissan_RPi_Motor_Controller_v2.kicad_sch, H_bridge.kicad_sch, MCU.kicad_sch, Power_supplies.kicad_sch, SPI_port.kicad_sch, analog_module.kicad_sch, eeprom.kicad_sch]
2023-01-19 pcb is in progress, finishing H-bridge layout
    [Current_sense.kicad_sch, Debugger_port.kicad_sch, MCU.kicad_sch, Power_supplies.kicad_sch, SPI_port.kicad_sch, USART.kicad_sch, eeprom.kicad_sch]
2023-01-20 finished H-bridge layouts and replicate
    [Faurecia_Nissan_RPi_Motor_Controller_v2.kicad_pcb, Faurecia_Nissan_RPi_Motor_Controller_v2.kicad_sch, H_bridge.kicad_sch]
2023-01-20 start design power input
    [Current_sense.kicad_sch, Faurecia_Nissan_RPi_Motor_Controller_v2.kicad_pcb, Faurecia_Nissan_RPi_Motor_Controller_v2.kicad_sch, Power_supplies.kicad_sch]
2023-01-23 power part designed
    [Current_sense.kicad_sch, Faurecia_Nissan_RPi_Motor_Controller_v2.kicad_pcb, Faurecia_Nissan_RPi_Motor_Controller_v2.kicad_sch, MCU.kicad_sch, analog_module.kicad_sch]
2023-01-23 added pull-ups to the logic gates
    [Faurecia_Nissan_RPi_Motor_Controller_v2.kicad_sch, Logic_gates.kicad_sch, MCU.kicad_sch]
2023-01-23 ADC resistors and outputs added
    [Current_sense.kicad_sch, Faurecia_Nissan_RPi_Motor_Controller_v2.kicad_sch, Logic_gates.kicad_sch, MCU.kicad_sch, Power_supplies.kicad_sch, analog_module.kicad_sch]
2023-01-26 project finished before changes
    [Faurecia_Nissan_RPi_Motor_Controller_v2.kicad_sch, MCU.kicad_sch, Power_supplies.kicad_sch, SPI_port.kicad_sch, analog_module.kicad_sch]
2023-01-28 PCB correction
2023-01-30 v2.1 finished
    [Current_sense.kicad_sch, Debugger_port.kicad_sch, Faurecia_Nissan_RPi_Motor_Controller_v2.kicad_sch, H_bridge.kicad_sch, MCU.kicad_sch, Power_supplies.kicad_sch, SPI_port.kicad_sch, analog_module.kicad_sch]
2023-02-15 final version v2.1
    [Faurecia_Nissan_RPi_Motor_Controller_v2.kicad_sch, MCU.kicad_sch]
